Himmat14/EP1_Wind_Turbine_Aerodynamics_Code/Blade_vids_images/Blade Image 1.jpg

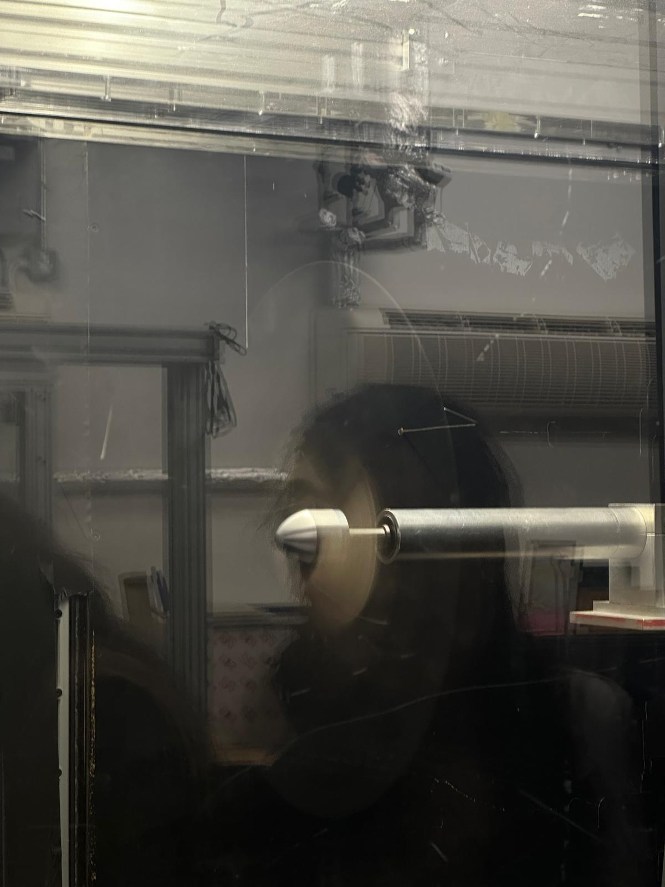
Blade_vids_images/Blade Image 1.jpg
