Himmat14/EP1_Wind_Turbine_Aerodynamics_Code/CTM_files/Flow chart BEM.png

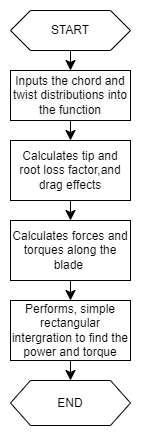
CTM_files/Flow chart BEM.png
