Himmat14/EP1_Wind_Turbine_Aerodynamics_Code/CTM_files/flow chart Itteration.png

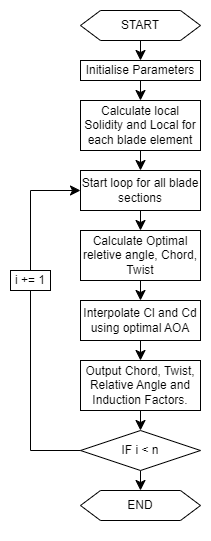
CTM_files/flow chart Itteration.png
