Himmat14/EP1_Wind_Turbine_Aerodynamics_Code/DBT_2/Angular induction factor.png

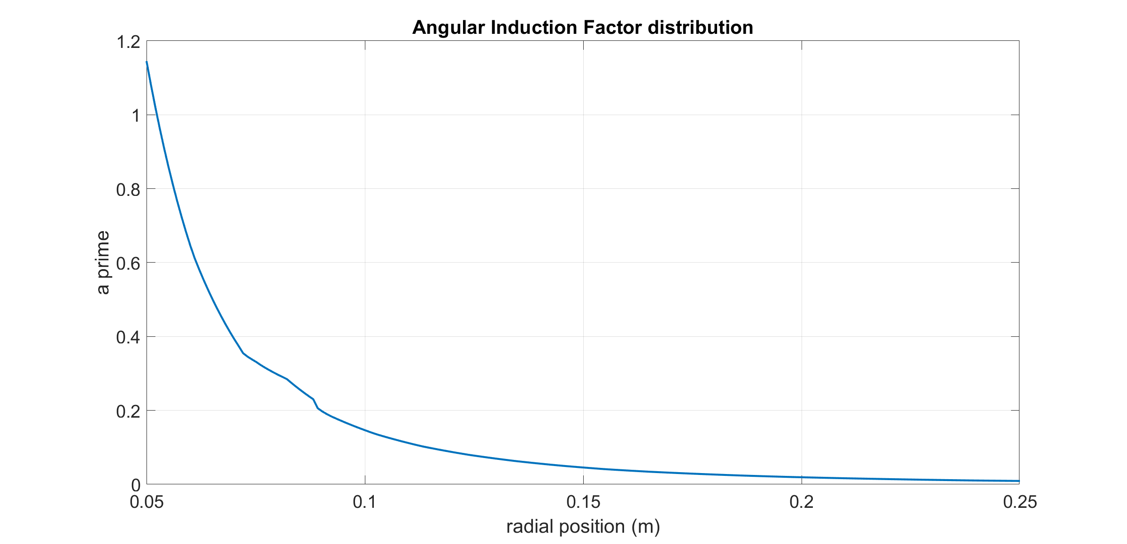
DBT_2/Angular induction factor.png
