Himmat14/EP1_Wind_Turbine_Aerodynamics_Code/DBT_2/Chord Distribution.png

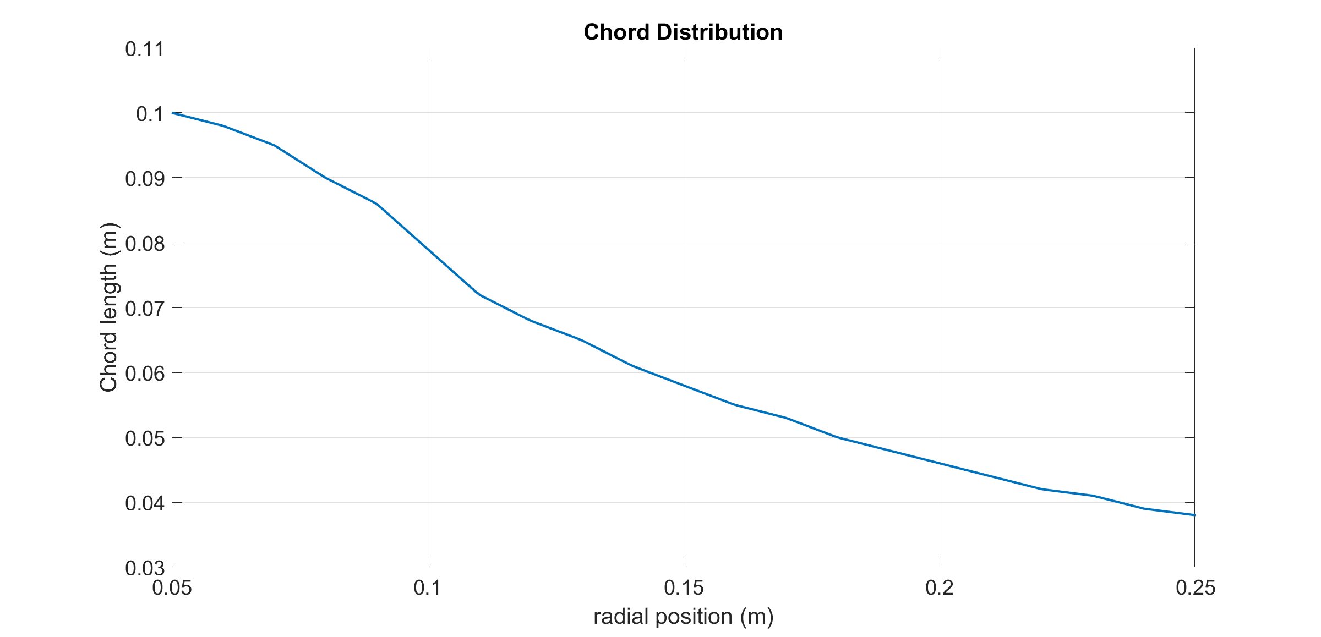
DBT_2/Chord Distribution.png
