Himmat14/EP1_Wind_Turbine_Aerodynamics_Code/DBT_2/CL_design dist.png

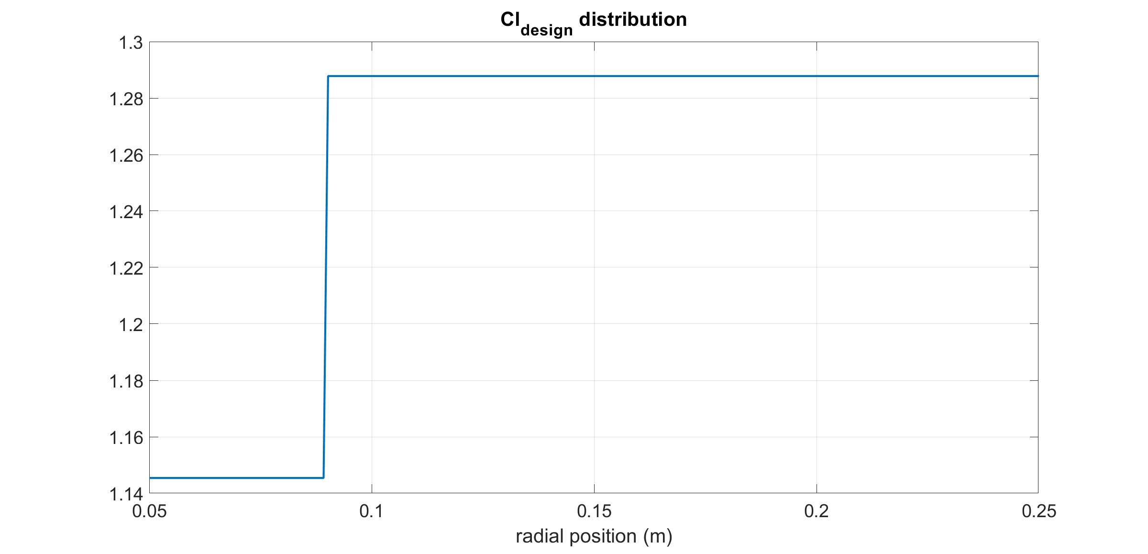
DBT_2/CL_design dist.png
