Himmat14/EP1_Wind_Turbine_Aerodynamics_Code/DBT_2/Power vs TSR.png

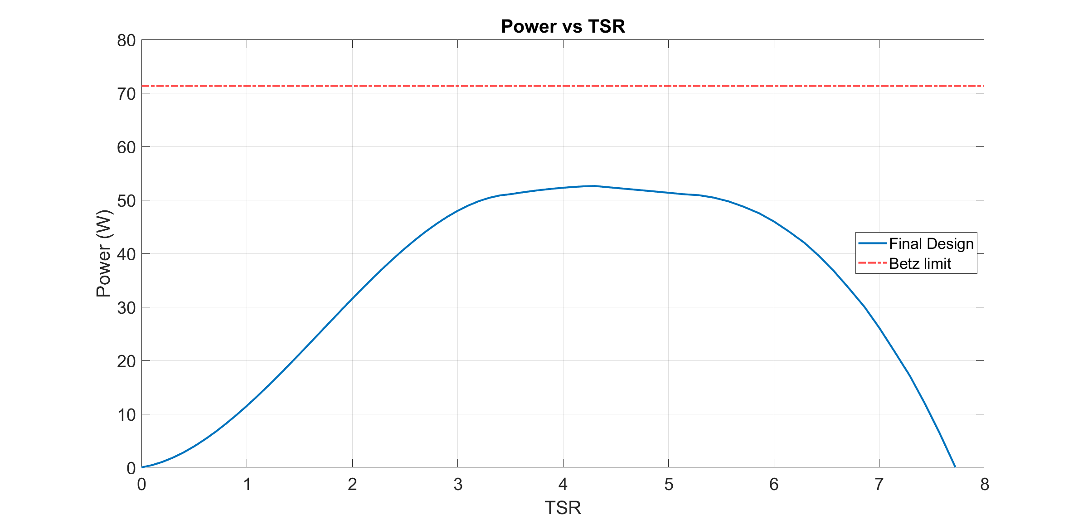
DBT_2/Power vs TSR.png
