Himmat14/EP1_Wind_Turbine_Aerodynamics_Code/Blade_CAD/2-blade Turbine Hub.stp

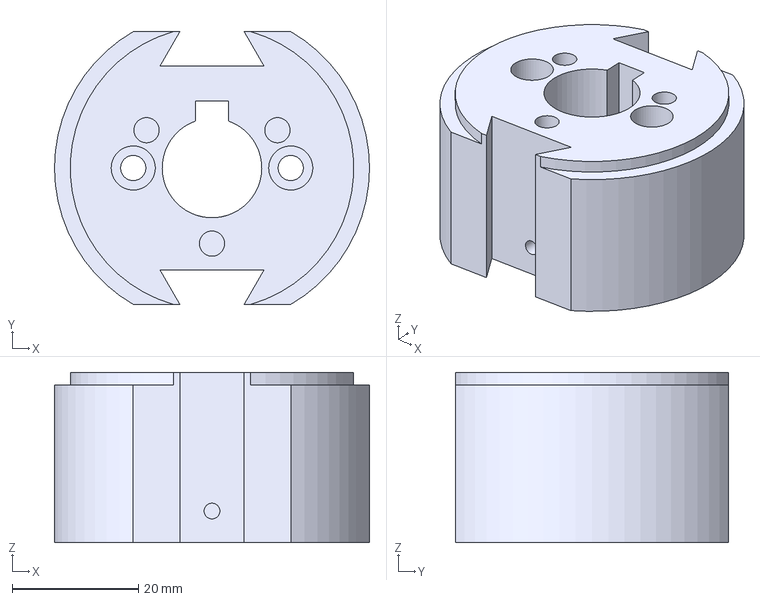
[picture p20: CAD file, 2025-06-13]
Blade_CAD/2-blade Turbine Hub.stp
50.0 x 43.3 x 27.0 mm
