Himmat14/EP1_Wind_Turbine_Aerodynamics_Code/MFR_FILES/Balsa Plate 4.dxf

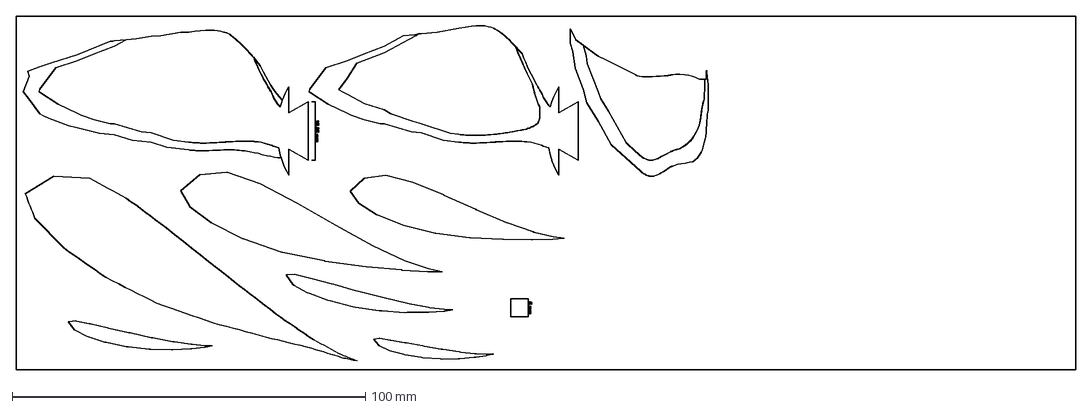
[picture p21: CAD file, 2025-06-13]
MFR_FILES/Balsa Plate 4.dxf
300.0 x 100.0 mm
