Himmat14/EP1_Wind_Turbine_Aerodynamics_Code/MFR_FILES/UMS5_Turbine Blade v5 v1.3mf

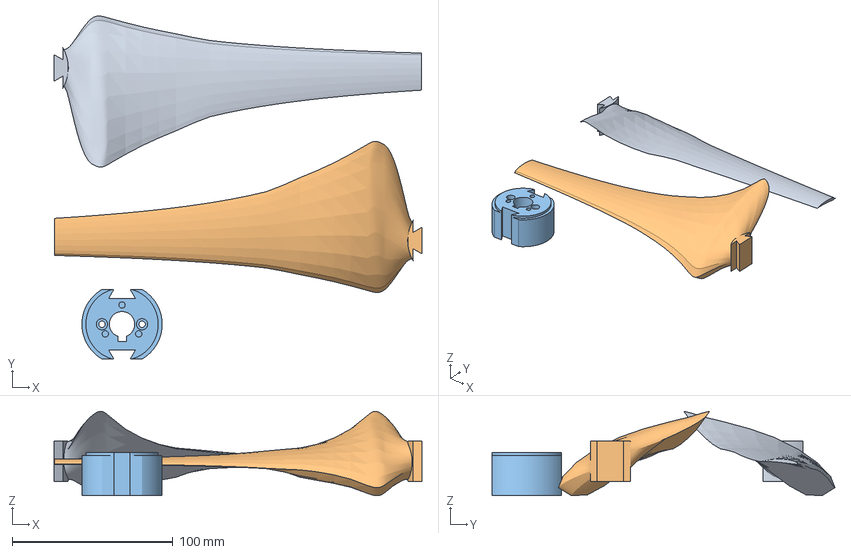
[picture p23: CAD file, 2025-06-13]
MFR_FILES/UMS5_Turbine Blade v5 v1.3mf
229.1 x 213.6 x 52.6 mm
Turbine Blade v5 v1.stl
Turbine Blade v5 v1.stl(1)
2-blade Turbine Hub v2.stl
