Himmat14/EP1_Wind_Turbine_Aerodynamics_Code/MFR_FILES/Turbine Blade v5.step

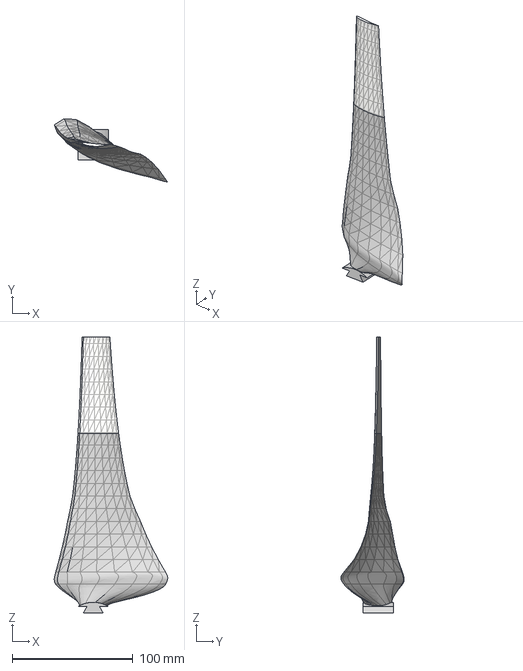
[picture p24: CAD file, 2025-06-13]
MFR_FILES/Turbine Blade v5.step
94.2 x 52.6 x 228.8 mm
