Himmat14/EP1_Wind_Turbine_Aerodynamics_Code/MFR_FILES/Plywood Plate.dxf A.1.dxf

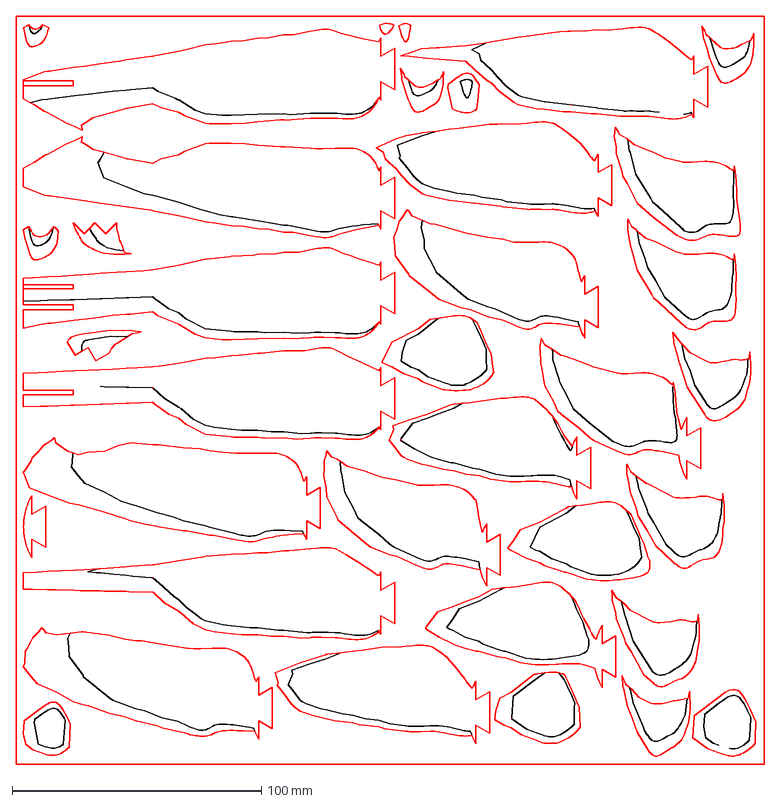
[picture p25: CAD file, 2025-06-13]
MFR_FILES/Plywood Plate.dxf A.1.dxf
300.0 x 300.0 mm
