Himmat14/EP1_Wind_Turbine_Aerodynamics_Code/MFR_FILES/Balsa Plate 2.dxf

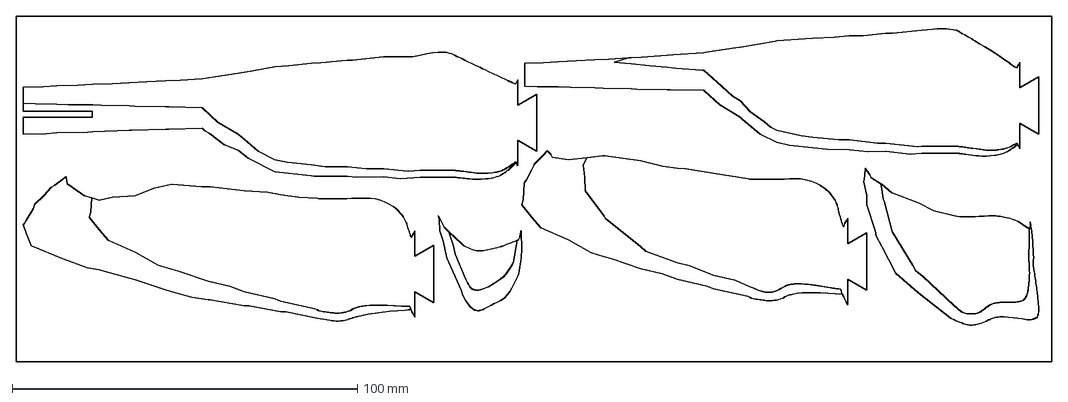
[picture p28: CAD file, 2025-06-13]
MFR_FILES/Balsa Plate 2.dxf
300.0 x 100.0 mm
