Himmat14/EP1_Wind_Turbine_Aerodynamics_Code/(list of files, cad)

Other CAD files:
Blade_CAD/2-blade Turbine Hub v2.stl
MFR_FILES/Turbine Blade v5 v1.stl
