Himmat14/EP1_Wind_Turbine_Aerodynamics_Code/DBT_2/testdatafinal_plotting.xlsx

position | chord | twist (rad) | twist (deg) | aoa distribution | aoa distribution (deg) | cl used from aerofoil des | CL | CD | a | a (ideal) | a PRIME
0.05 | 0.1 | 0.4743281308 | 27.177 | 0.1396263402 | 8 | 1.1454 | 1.348416981 | 0.2009931729 | 0.2241383821 | 0.33 | 1.145286445
0.05100502513 | 0.09979899497 | 0.4683291097 | 26.83328141 | 0.1396263402 | 8 | 1.1454 | 1.347300283 | 0.1999475375 | 0.2246889878 | 0.33 | 1.081649087
0.05201005025 | 0.09959798995 | 0.4623300885 | 26.48956281 | 0.1396263402 | 8 | 1.1454 | 1.345795386 | 0.1985384073 | 0.2253837701 | 0.33 | 1.021272182
0.05301507538 | 0.09939698492 | 0.4563310674 | 26.14584422 | 0.1396263402 | 8 | 1.1454 | 1.343958287 | 0.1968182138 | 0.2262781795 | 0.33 | 0.9641354725
0.0540201005 | 0.0991959799 | 0.4503320462 | 25.80212563 | 0.1396263402 | 8 | 1.1454 | 1.341843514 | 0.1948380172 | 0.2272212723 | 0.33 | 0.910162908
0.05502512563 | 0.09899497487 | 0.4443330251 | 25.45840704 | 0.1396263402 | 8 | 1.1454 | 1.339502126 | 0.1926456267 | 0.228373097 | 0.33 | 0.8592401378
0.05603015075 | 0.09879396985 | 0.4383340039 | 25.11468844 | 0.1396263402 | 8 | 1.1454 | 1.336980538 | 0.1902845034 | 0.2297839188 | 0.33 | 0.8112285494
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
