Himmat14/EP1_Wind_Turbine_Aerodynamics_Code/Aero_data/testdatfinal.xlsx

NREL S823 | SG6043 | SG6043
positions | chord(m) | twist(Deg) | foil
0.05 | 0.1 | 27.177 | nrel s823
0.06 | 0.098 | 23.757 | nrel s823
0.07 | 0.095 | 20.816 | nrel s823
0.08 | 0.09 | 18.289 | nrel s823
0.09 | 0.086 | 16.11 | nrel s823
0.11 | 0.072 | 16.089 | sg6043
0.12 | 0.068 | 14.656 | sg6043
0.13 | 0.065 | 13.395 | sg6043
0.14 | 0.061 | 12.28 | sg6043
0.15 | 0.058 | 11.288 | sg6043
0.16 | 0.055 | 10.401 | sg6043
0.17 | 0.053 | 9.604 | sg6043
0.18 | 0.05 | 8.885 | sg6043
0.19 | 0.048 | 8.233 | sg6043
0.2 | 0.046 | 7.639 | sg6043
0.21 | 0.044 | 7.097 | sg6043
0.22 | 0.042 | 6.599 | sg6043
0.23 | 0.041 | 6.142 | sg6043
0.24 | 0.039 | 5.72 | sg6043
0.25 | 0.038 | 5.329 | sg6043
