Himmat14/EP1_Wind_Turbine_Aerodynamics_Code/DBT_2/testdat.xlsx

NREL S823 | SG6043 | SG6043 | NREL S823 | NACA 4415 | SG6043 | NACA 4415 | SG6043 | SG6043 | NACA 4415 | NACA 4415 | SG6043
positions | chord(m) | twist(Deg) | positions | chord(m) | twist(Deg) | positions | chord(m) | twist(Deg) | positions | chord(m) | twist(Deg)
0.025 | 0.076 | 35.848 | 0.025 | 0.076 | 35.848 | 0.025 | 0.075 | 36.848 | 0.025 | 0.075 | 36.848
0.037 | 0.084 | 29.633 | 0.037 | 0.084 | 29.633 | 0.037 | 0.083 | 30.633 | 0.037 | 0.083 | 30.633
0.049 | 0.083 | 24.516 | 0.049 | 0.083 | 24.516 | 0.049 | 0.082 | 25.516 | 0.049 | 0.082 | 25.514
0.05 | 0.083 | 24.009 | 0.05 | 0.082 | 25.009 | 0.05 | 0.078 | 27.509 | 0.061 | 0.078 | 21.365
0.061 | 0.075 | 23.864 | 0.061 | 0.078 | 21.365 | 0.061 | 0.075 | 23.865 | 0.072 | 0.073 | 18.008
0.072 | 0.07 | 20.508 | 0.072 | 0.073 | 18.008 | 0.072 | 0.07 | 20.508 | 0.084 | 0.068 | 15.276
0.084 | 0.065 | 17.776 | 0.084 | 0.068 | 15.276 | 0.084 | 0.065 | 17.776 | 0.096 | 0.063 | 13.03
0.096 | 0.06 | 15.53 | 0.096 | 0.063 | 13.03 | 0.096 | 0.06 | 15.53 | 0.108 | 0.058 | 11.162
0.108 | 0.055 | 13.663 | 0.108 | 0.058 | 11.163 | 0.108 | 0.055 | 13.663 | 0.12 | 0.054 | 9.594
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
