Himmat14/EP1_Wind_Turbine_Aerodynamics_Code/Blade Drawings/Blade_Assembly_Drawing_G20.pdf

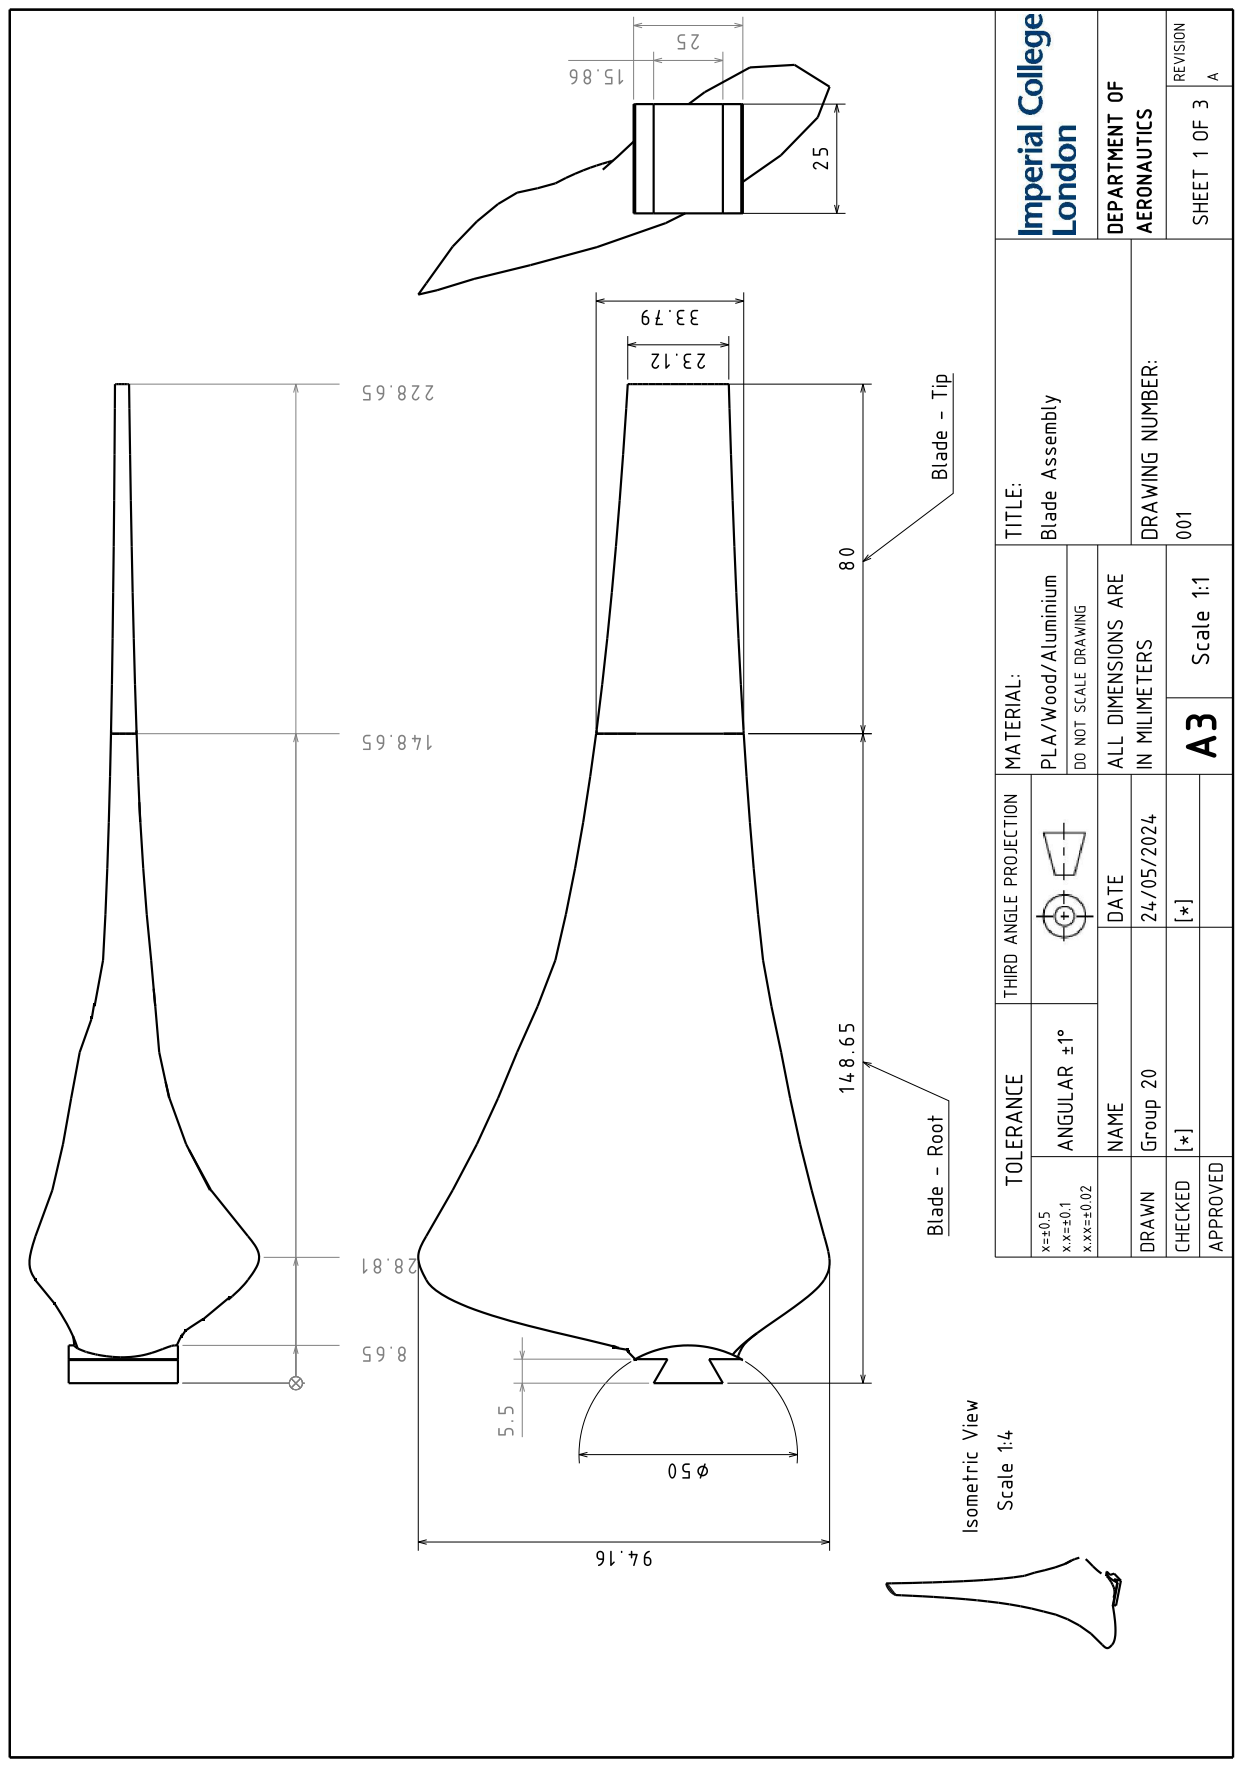
[picture p31: page 1]
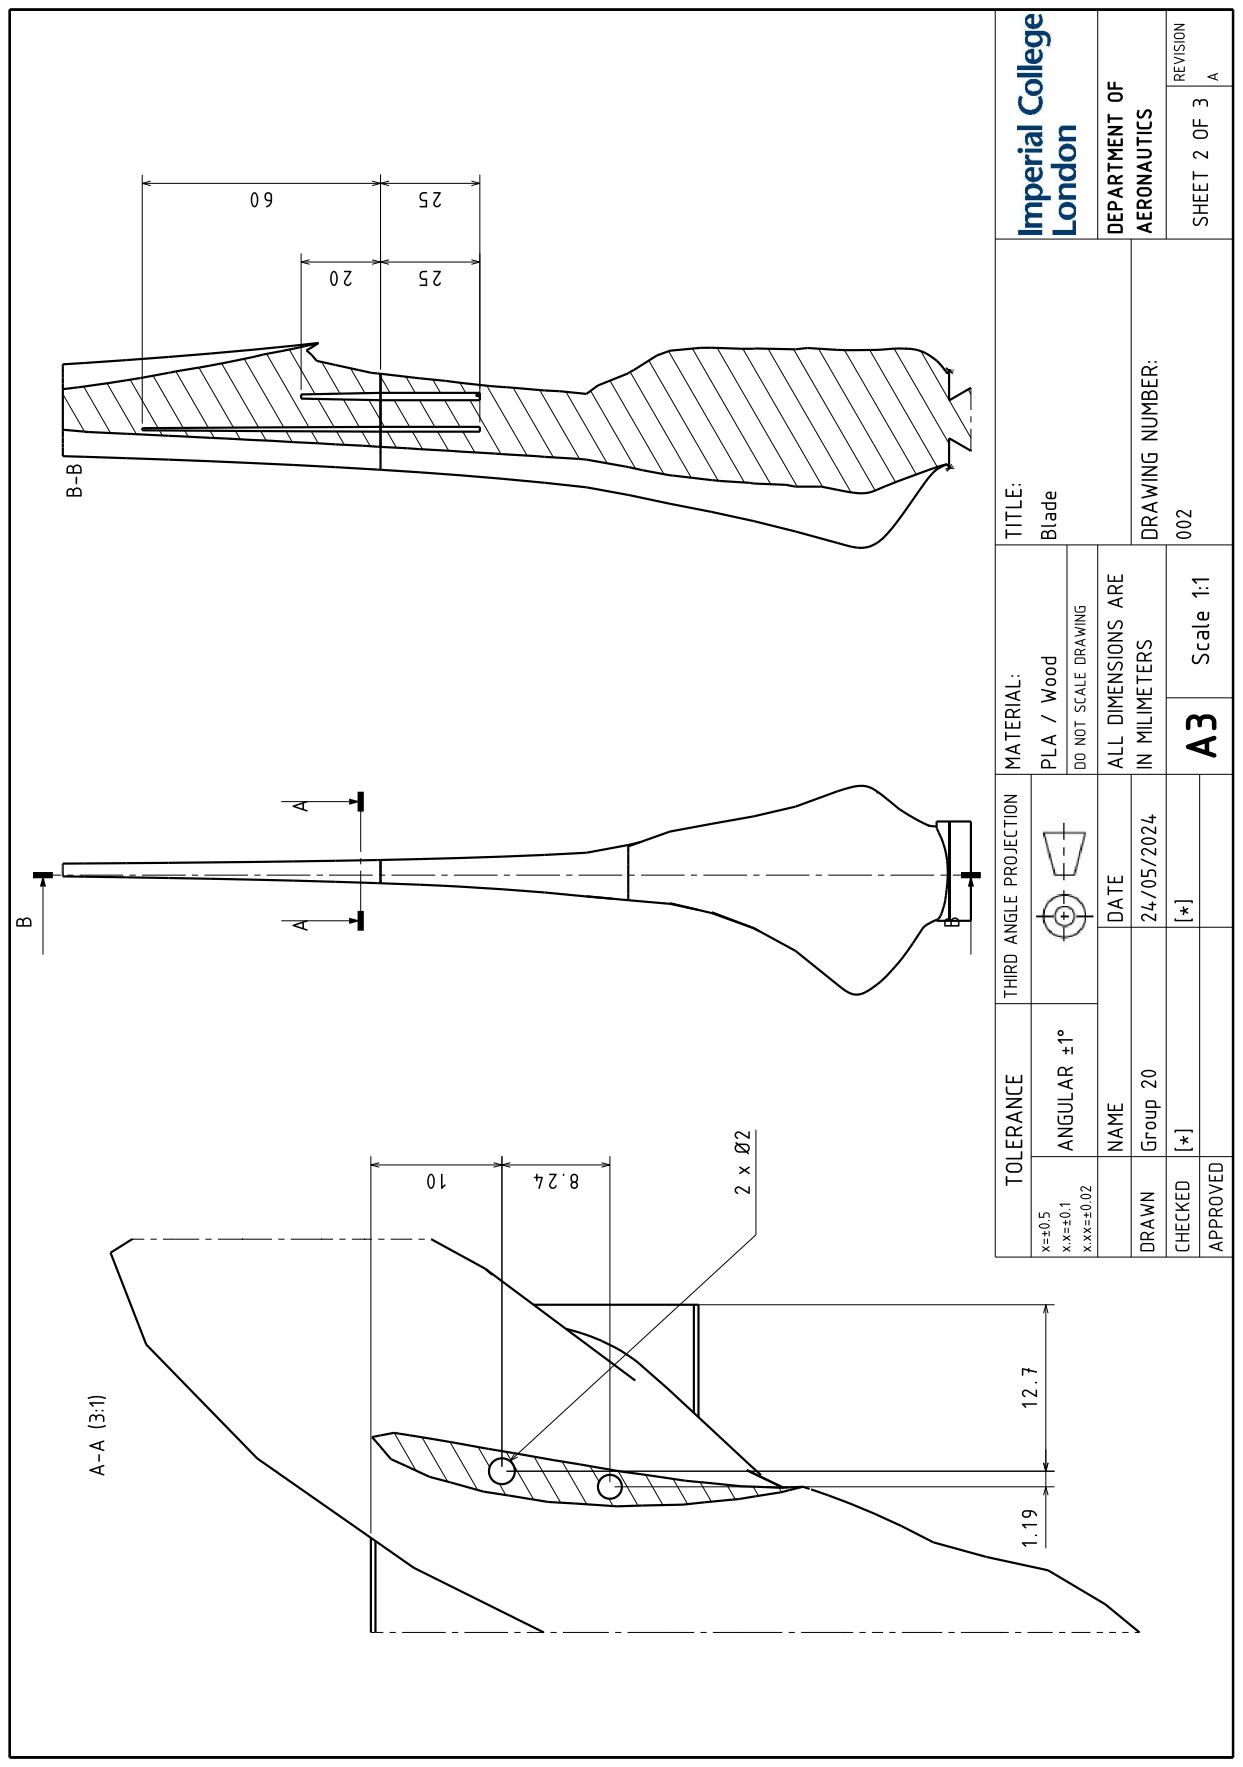
[picture p32: page 2]
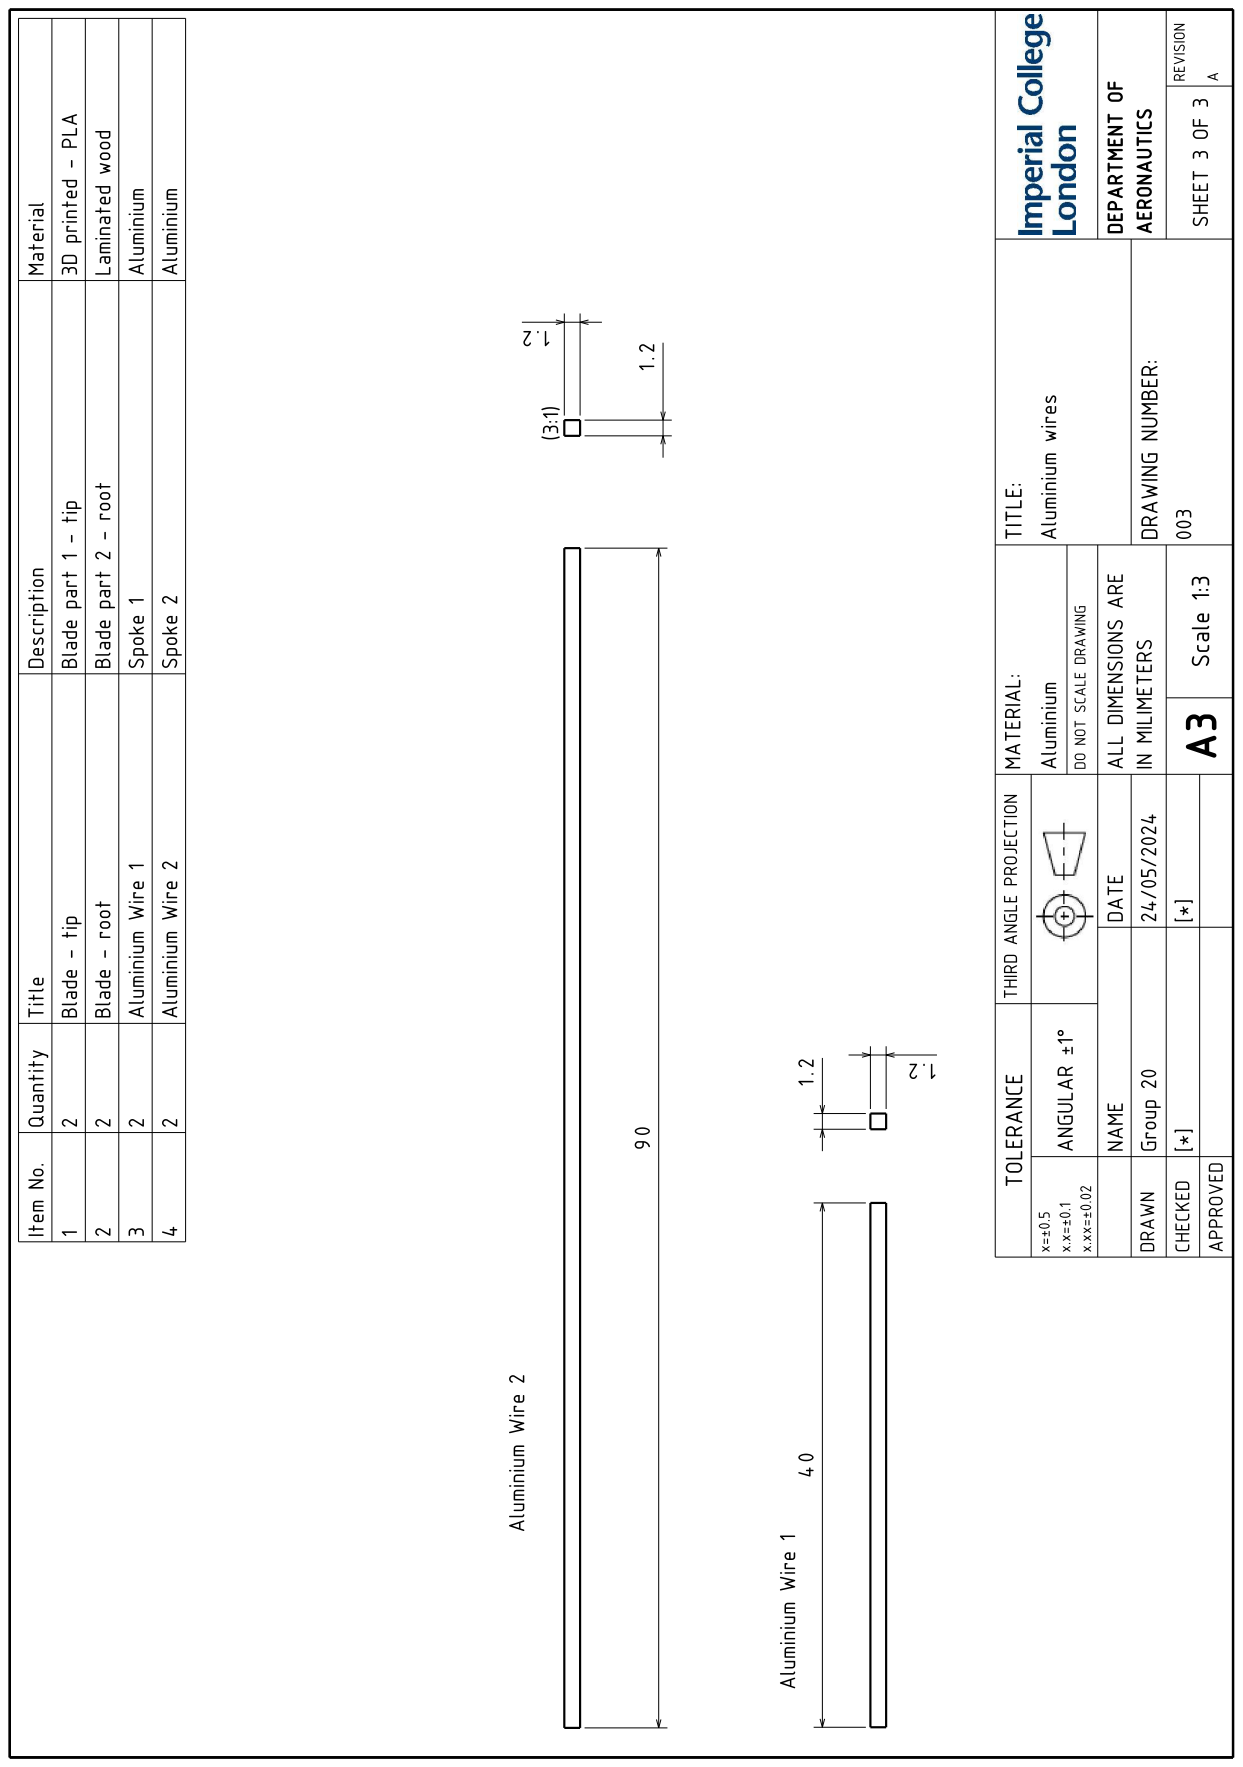
[picture p33: page 3]
