Himmat14/EP1_Wind_Turbine_Aerodynamics_Code/MFR_FILES/Balsa Plate 1.pdf

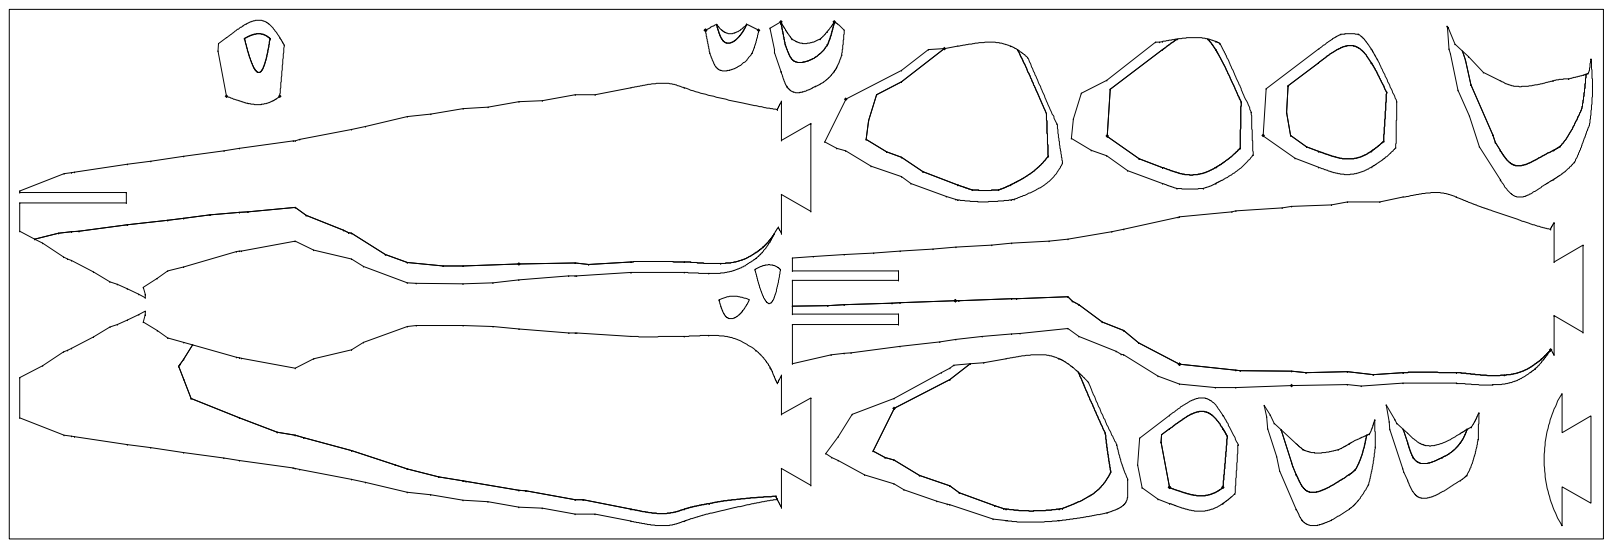
[picture p34: page 1]
