Himmat14/EP1_Wind_Turbine_Aerodynamics_Code/MFR_FILES/Plate 1.pdf

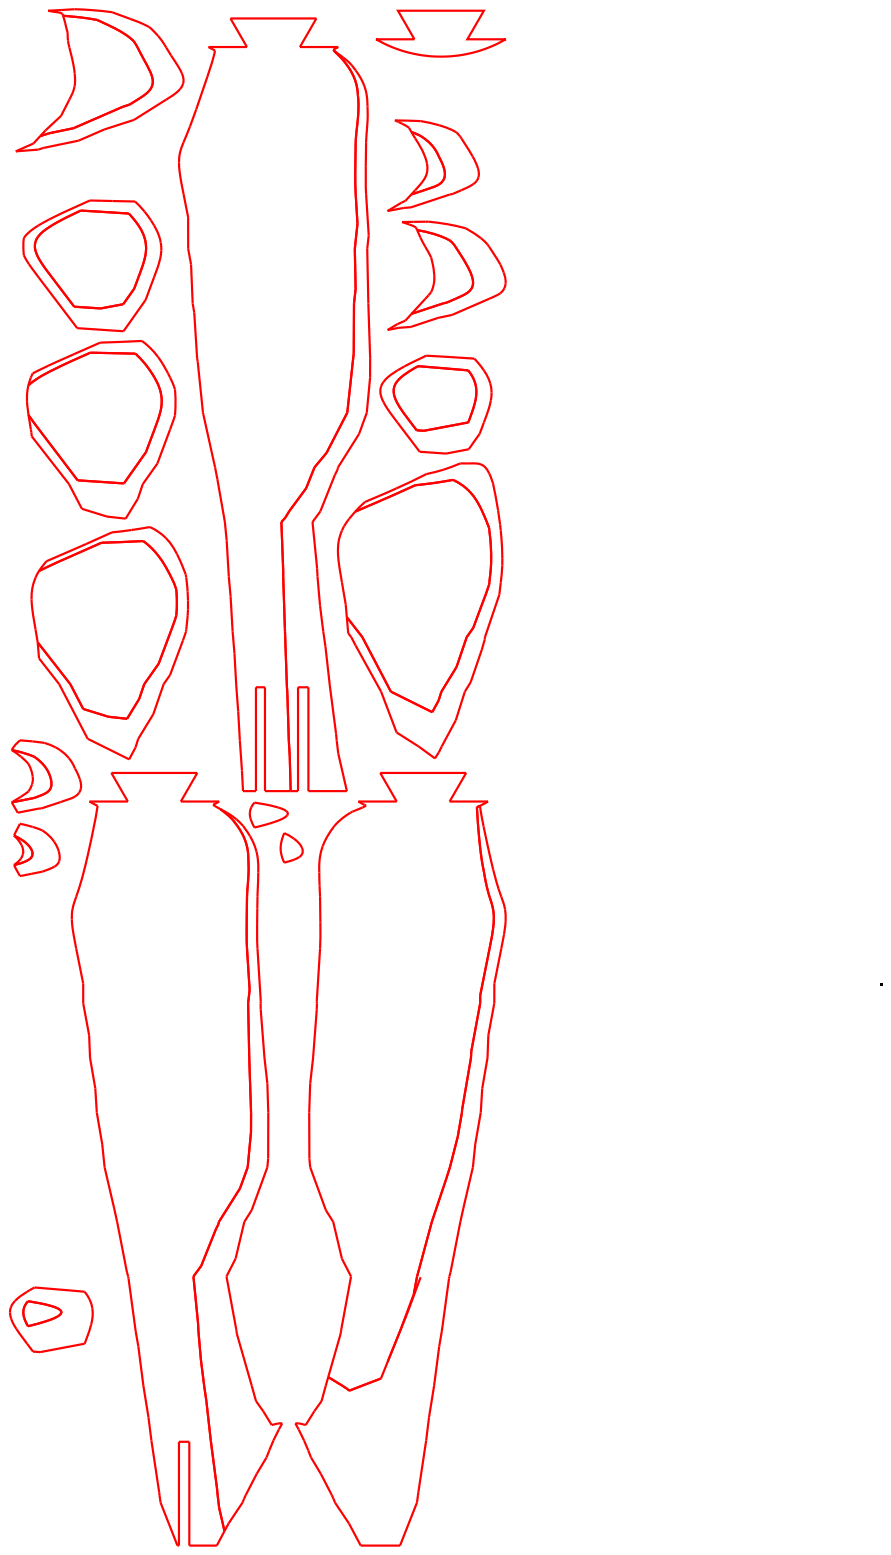
[picture p35: page 1]
