Himmat14/EP1_Wind_Turbine_Aerodynamics_Code/MFR_FILES/Plate 2.pdf

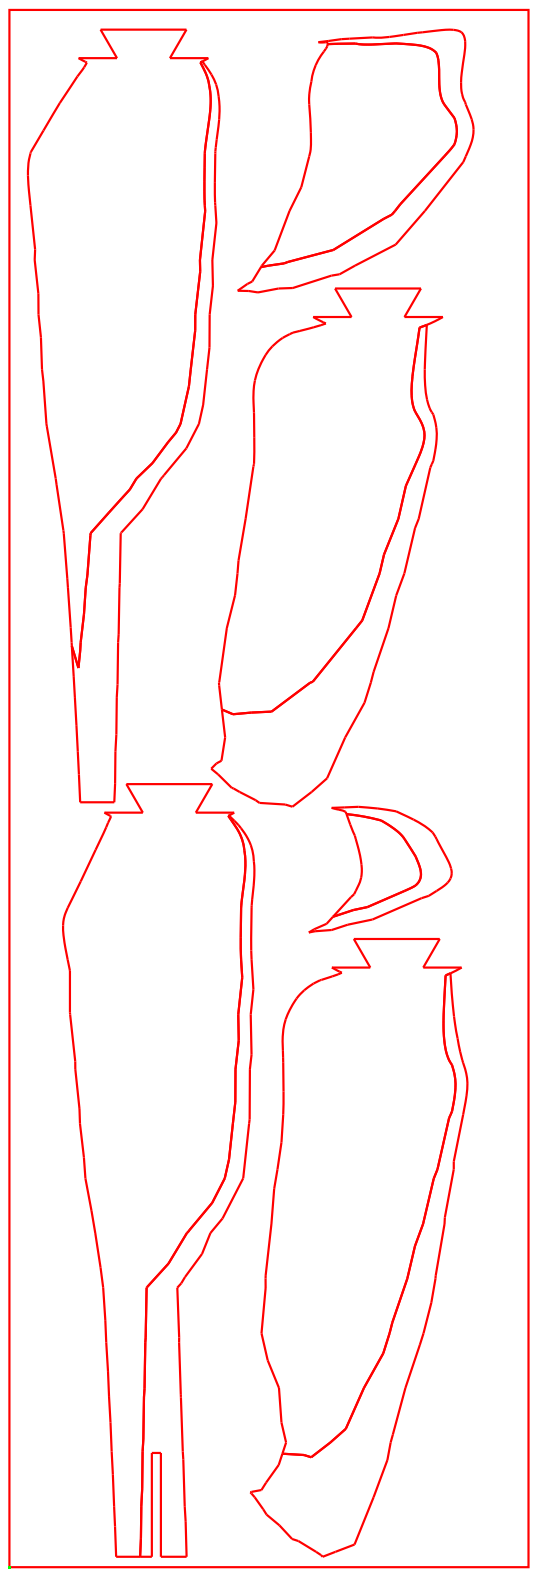
[picture p36: page 1]
