Himmat14/EP1_Wind_Turbine_Aerodynamics_Code/MFR_FILES/Plate 3.pdf

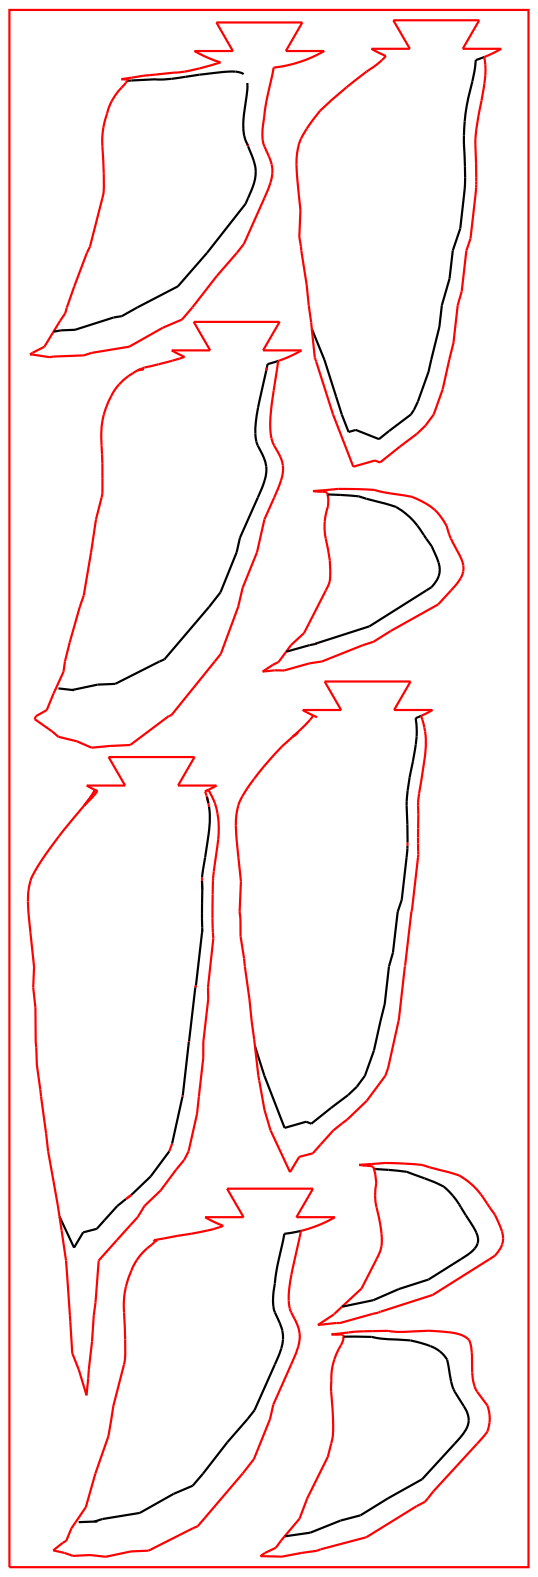
[picture p37: page 1]
