Himmat14/EP1_Wind_Turbine_Aerodynamics_Code/MFR_FILES/Plate 4.pdf

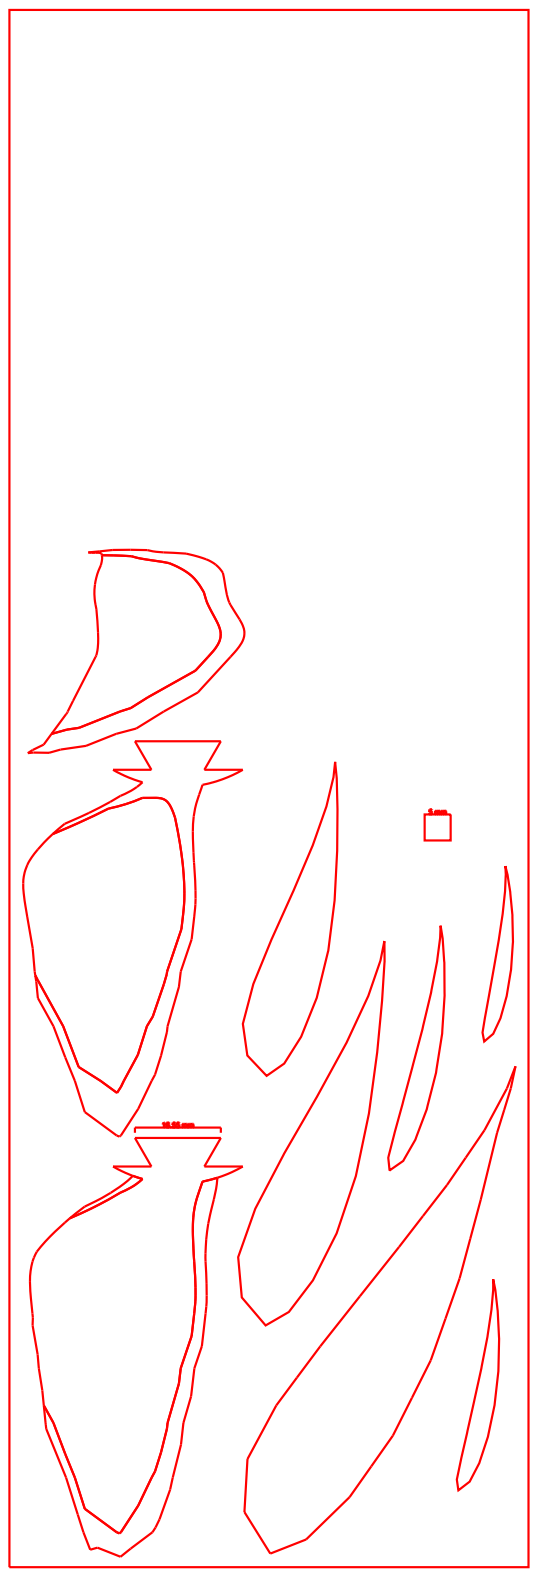
[picture p38: page 1]
