Himmat14/EP1_Wind_Turbine_Aerodynamics_Code/MFR_FILES/PLYWOOD PLATE FINAL.pdf

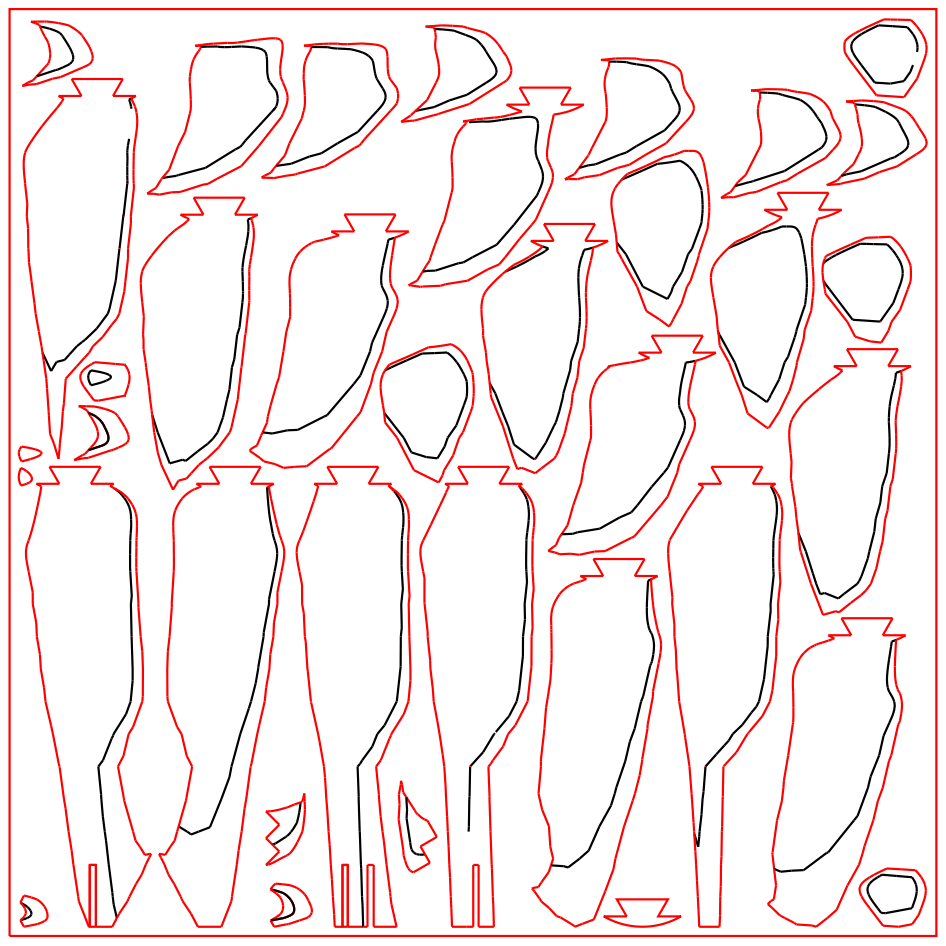
[picture p39: page 1]
