Himmat14/EP1_Wind_Turbine_Aerodynamics_Code/MFR_FILES/Plywood_Plate_Final_2.pdf

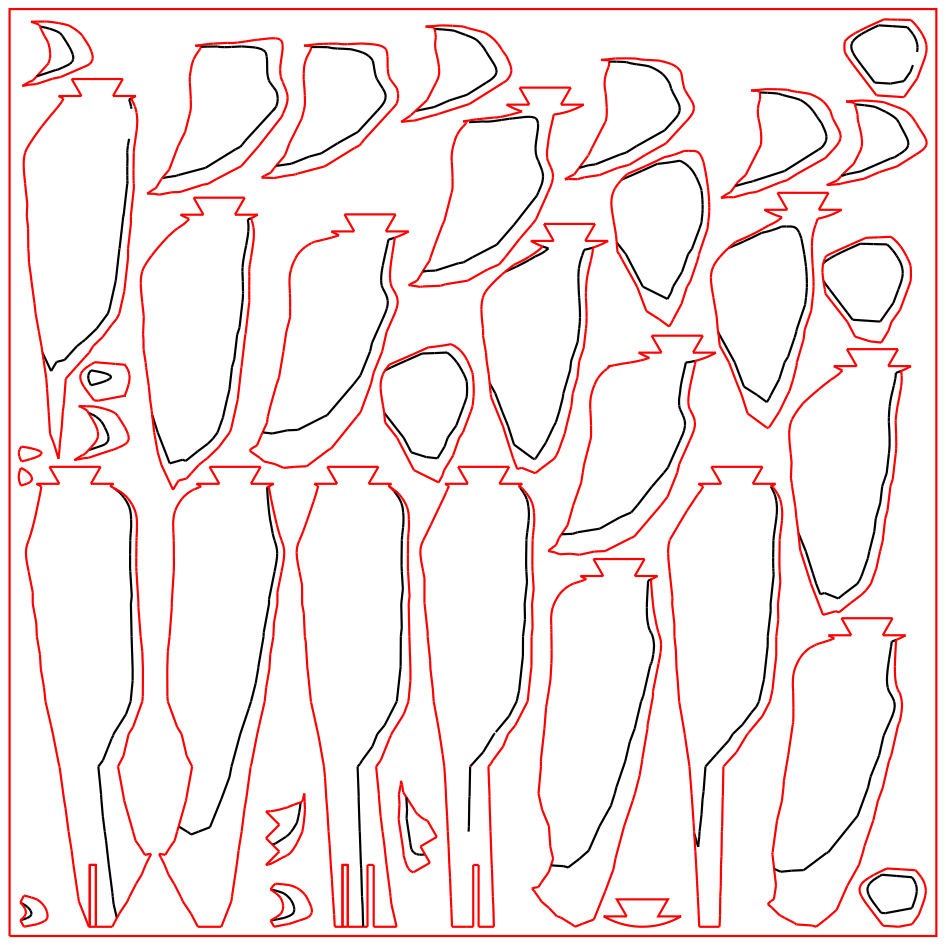
[picture p40: page 1]
