Himmat14/EP1_Wind_Turbine_Aerodynamics_Code/Blade Drawings/DMT_PED_G20.pdf

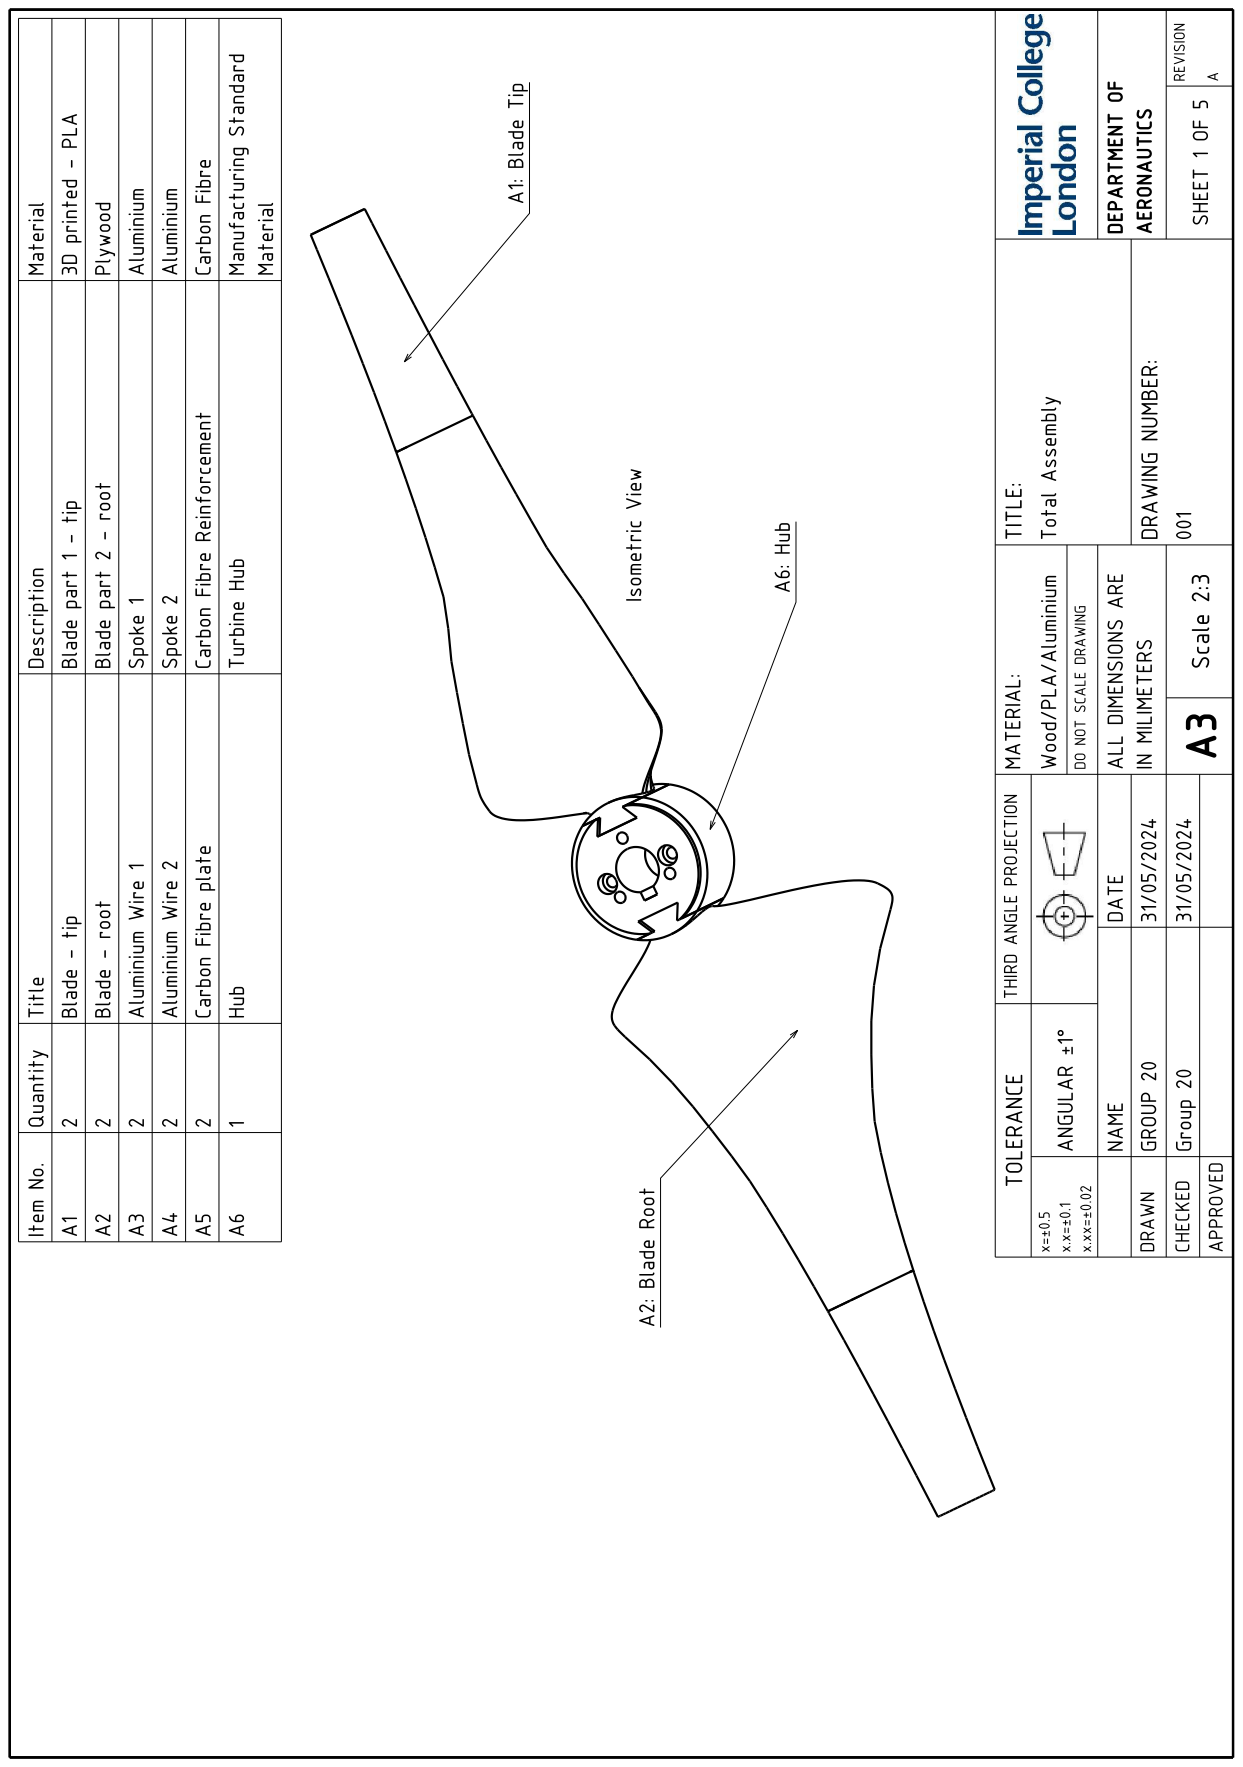
[picture p41: page 1]
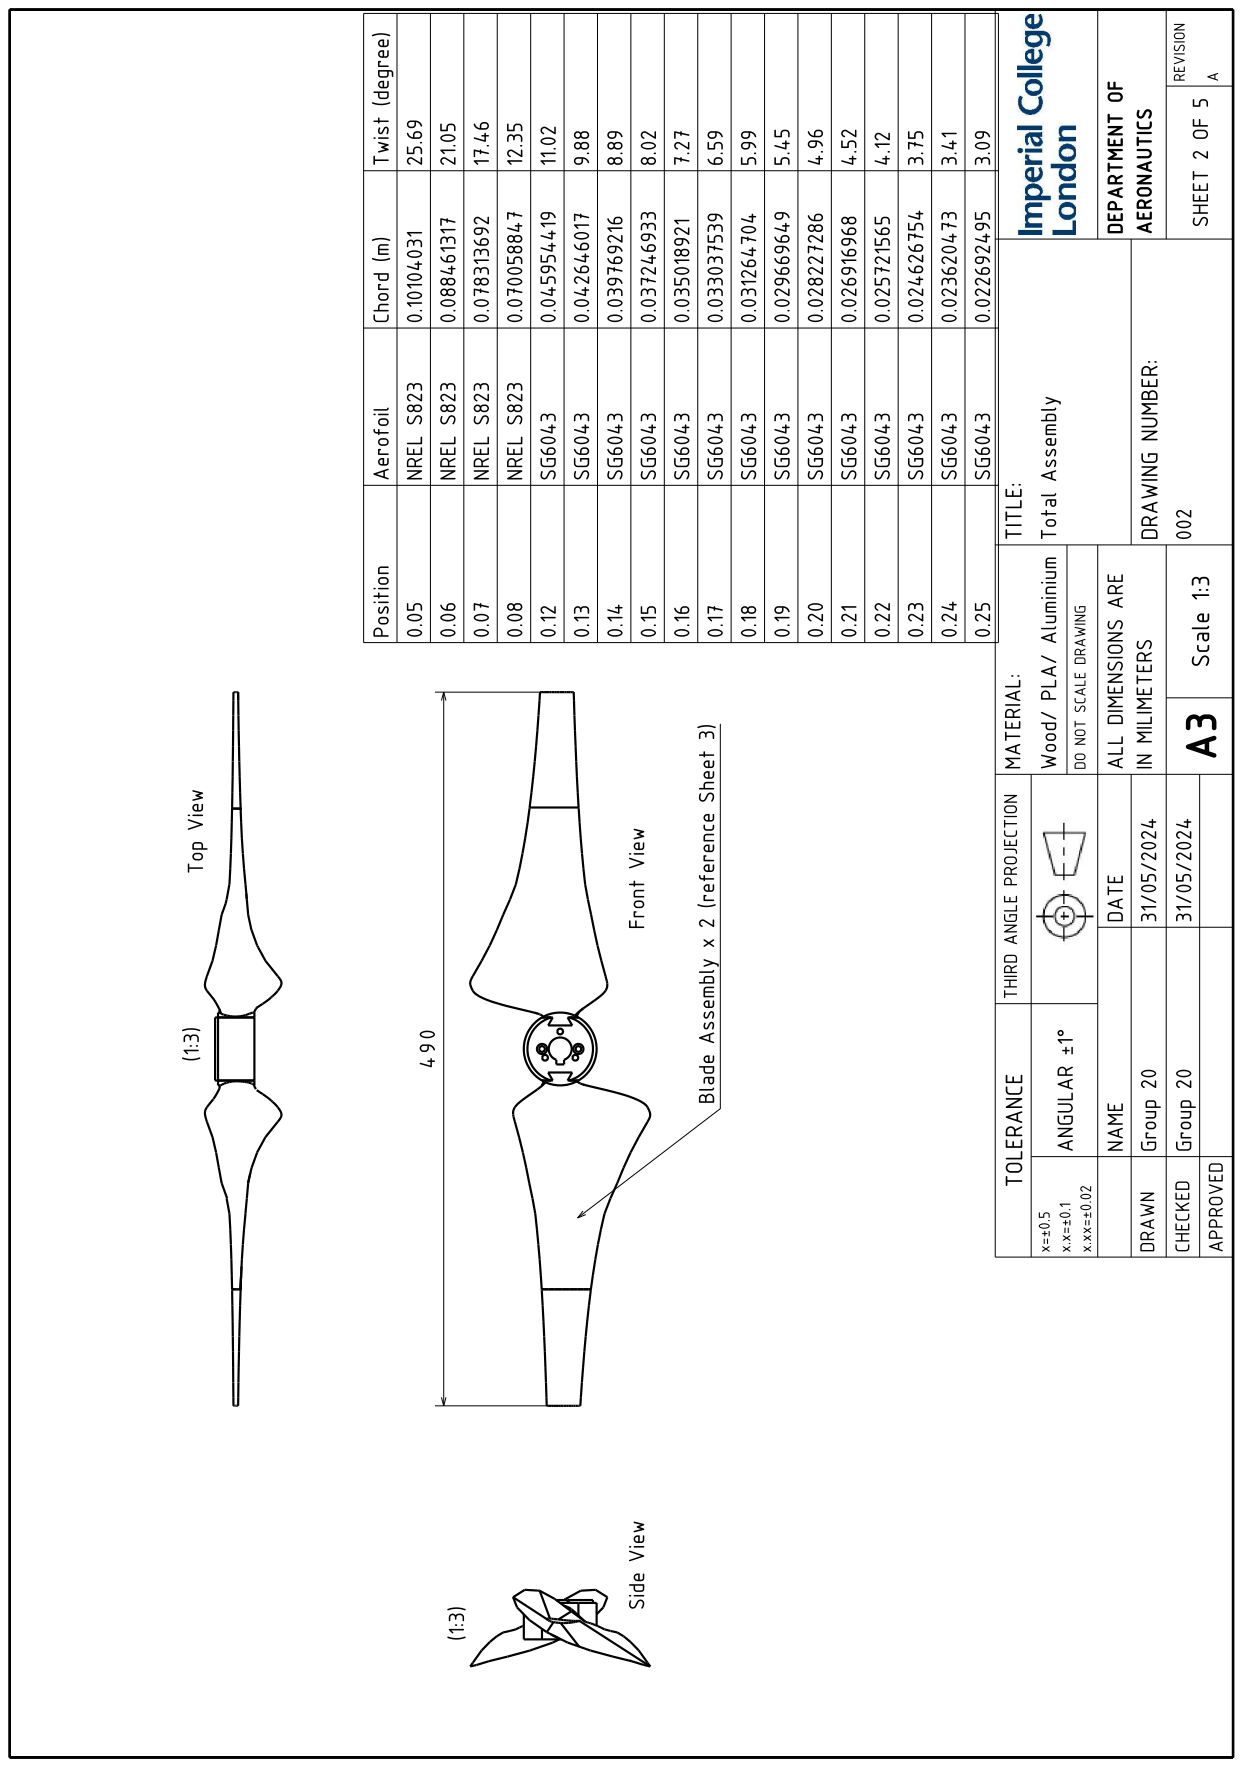
[picture p42: page 2]
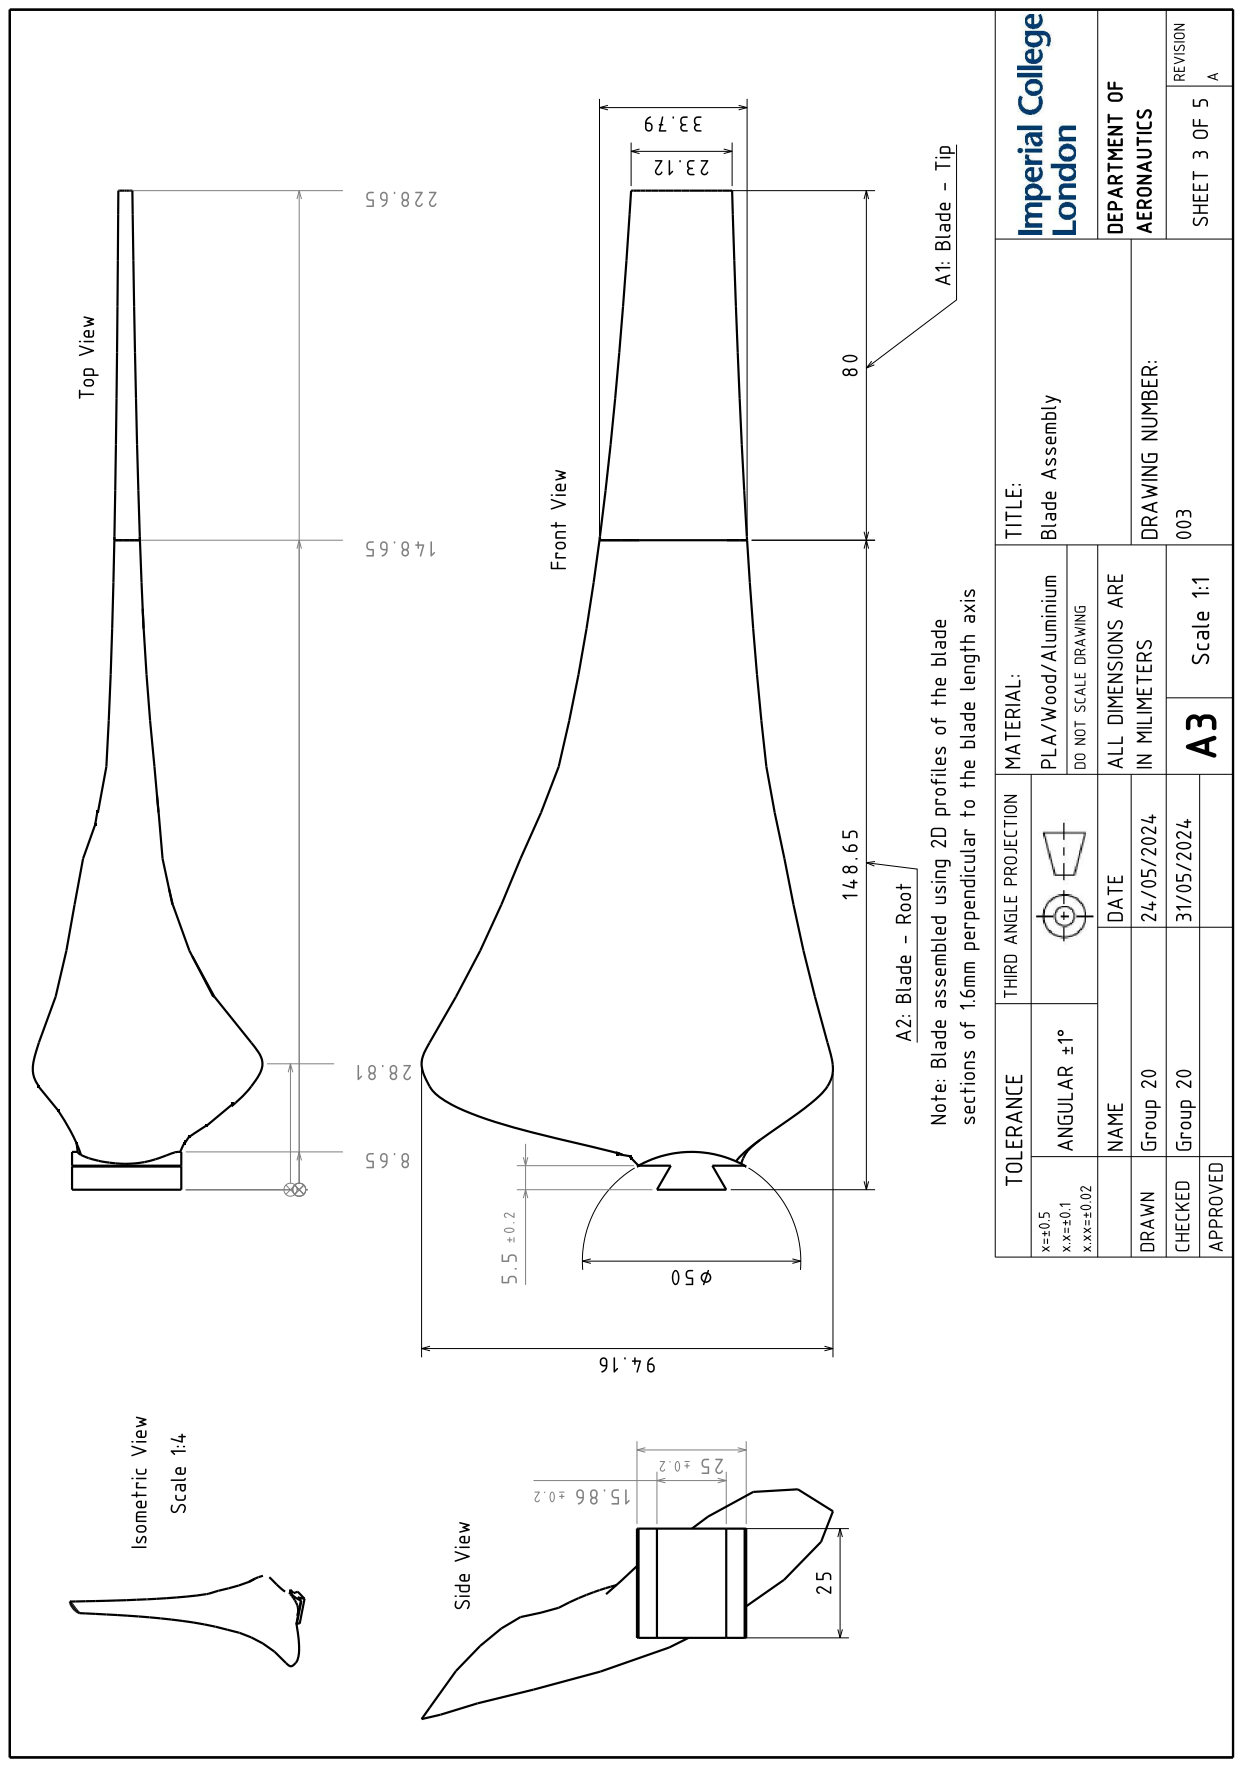
[picture p43: page 3]
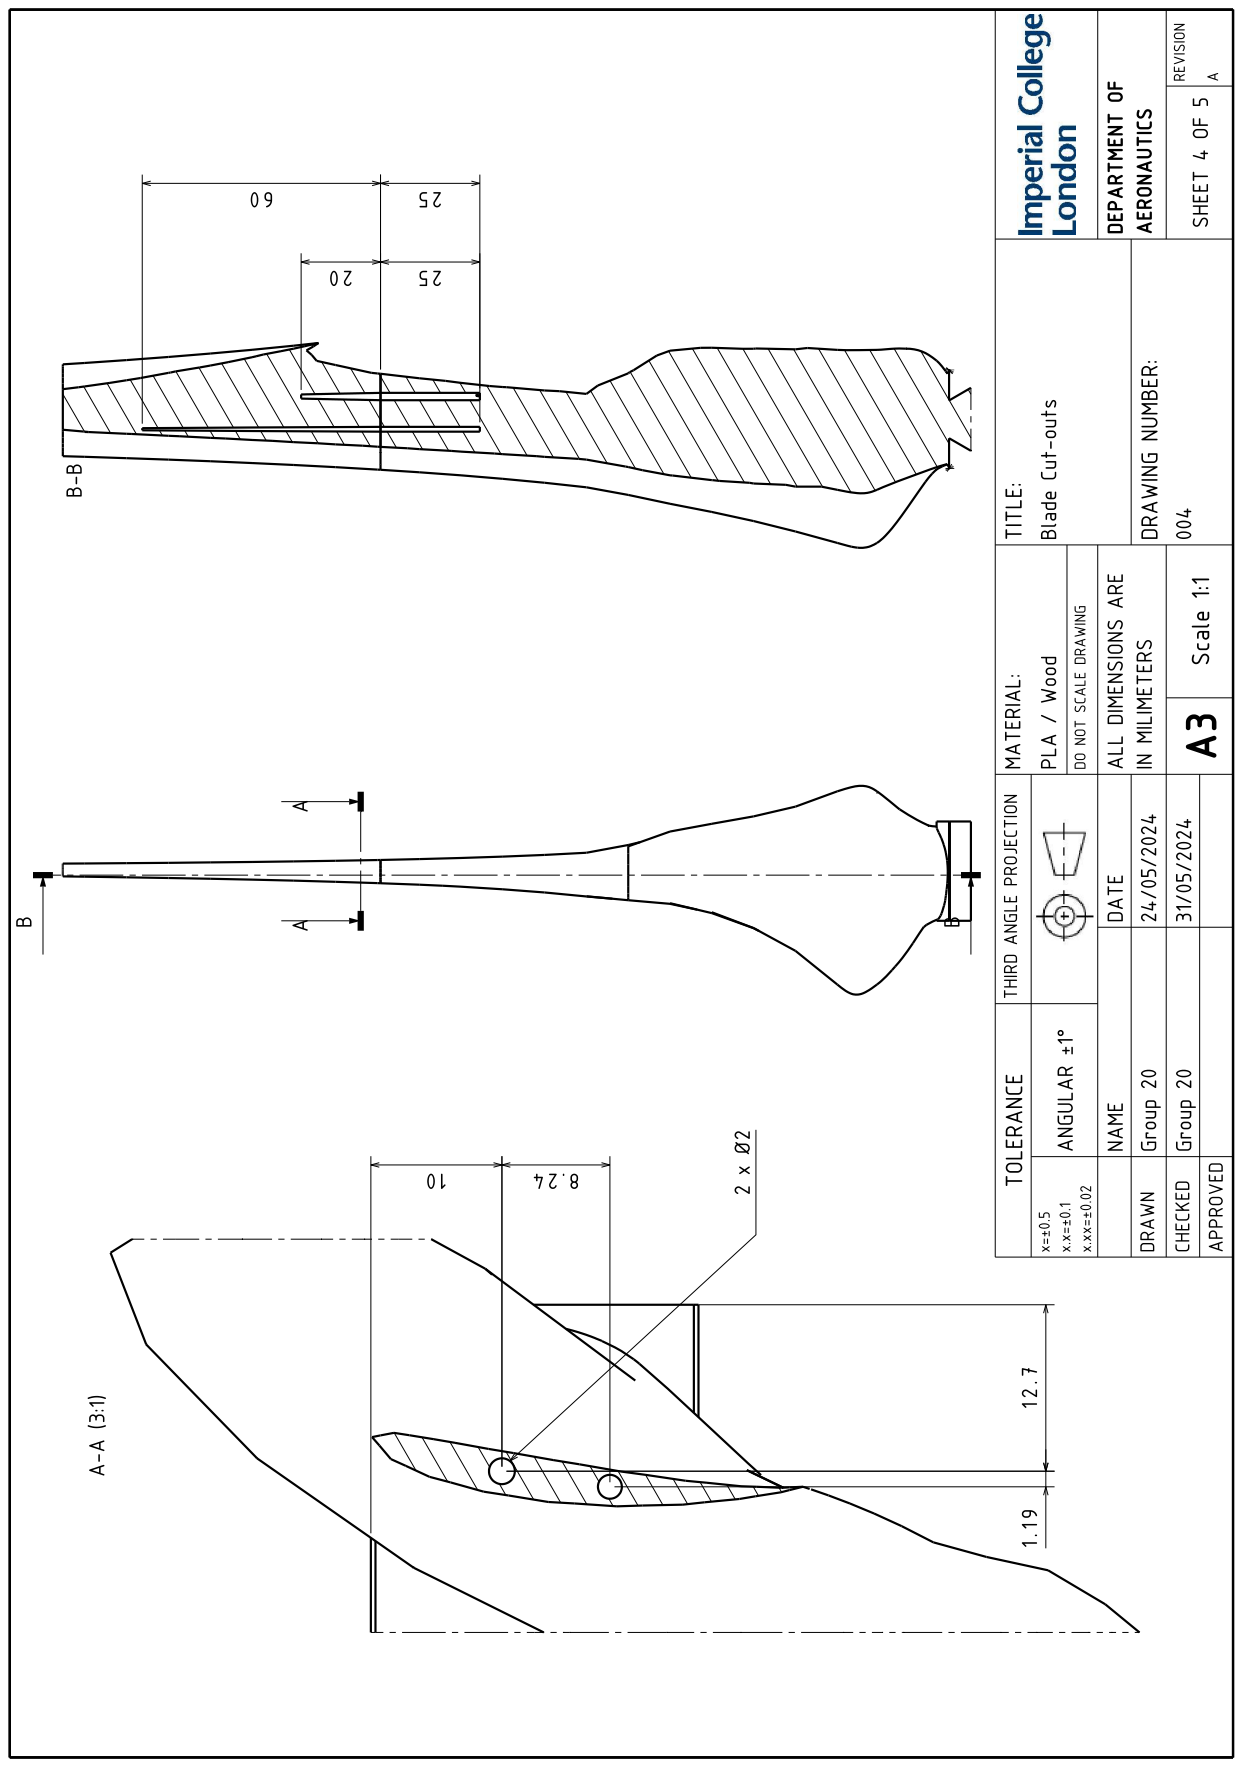
[picture p44: page 4]
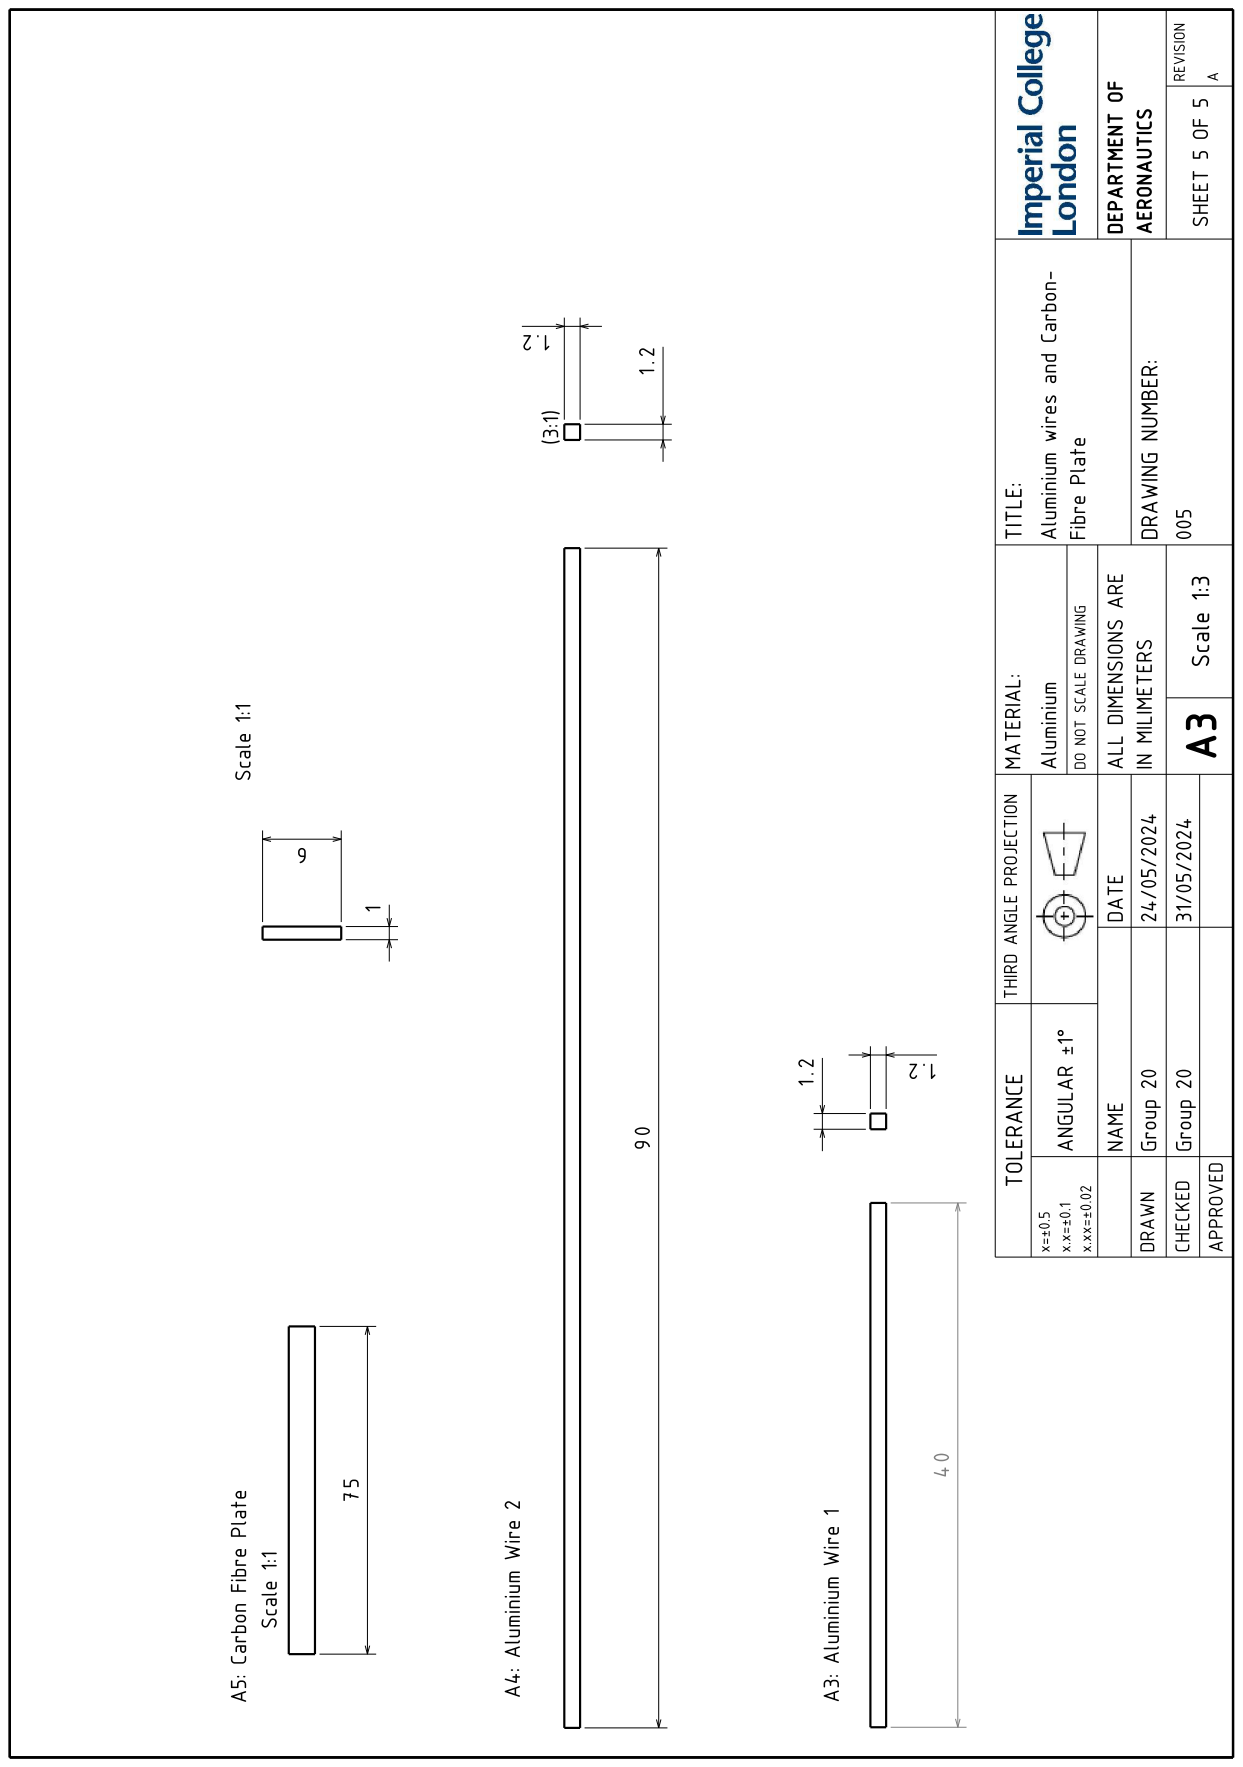
[picture p45: page 5]
