Himmat14/EP1_Wind_Turbine_Aerodynamics_Code/Scale MFR/Youngs Modulus vs Density.pdf

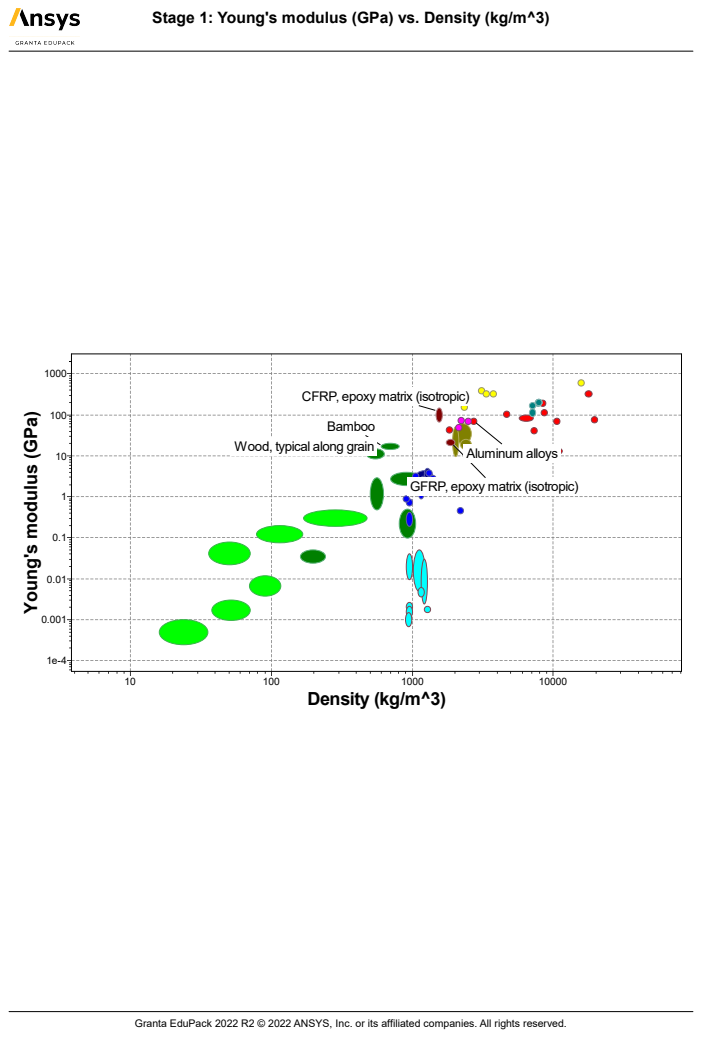
[picture p30: page 1]
Density (kg/m^3); 10000 Young's modulus ⁽GPa⁾; Bamboo; Aluminum alloys

Stage 1: Young's modulus (GPa) vs. Density (kg/m^3)

CFRP, epoxy matrix (isotropic)

Wood, typical along grain

GFRP, epoxy matrix (isotropic)

Granta EduPack 2022 R2 © 2022 ANSYS, Inc. or its affiliated companies. All rights reserved.
